markuschr/worklight/README.md

# worklight

Portable 10 W COB LED worklight powered by a 12 V electric drill battery. 

3D printed case, passive cooling, dimmer, low battery warning LED, overdischarge protection. 

This project was done as a part of Principles of repurposing of electronics course at University of Oulu.
