markuschr/worklight/development_notes.md

# LED worklight

Making of a 10 W LED worklight which is connectable to a 12 V Biltema cordless drill battery. Dimmer, low battery LED indicator, and overdischarge protection were implemented.
This project was done as a part of Principles of repurposing of electronics course at University of Oulu.
20211219_162441-COLLAGE

# Parts used

-10 W COB LED (https://www.ebay.de/itm/High-Power-COB-LED-Chip-10W-20W-30W-50W-100W-36V-DC-Fluter-Flutlicht-Leuchte/113407196102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)

-12 V 1.3 Ah cordless drill battery (https://docs.biltema.com/v2/documents/file/fi/f697c127-bde8-4838-9511-e1e3a682050f)

-5A DC-DC Step Down Buck Converter Module with current limiter (https://www.ebay.de/itm/402128636453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)

-old USB car charger

-old computer processor cooling element

-Wemos D1 mini microcontroller (https://www.ebay.de/itm/255283312826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)

-IRLI530NPbF logic level MOSFET (https://www.infineon.com/dgdl/irli530npbf.pdf?fileId=5546d462533600a401535663f87d25bf)

-3mm red LED

-connection board

-on/off switch

-fuse

-10 kohm potentiometer (https://www.spelektroniikka.fi/p11624-monopotentiometri-10-kohm-lineaarinen-metallia-booritettu-akseli-fi.html)

-resistors: 11 kohm, 10 kohm, 3.32 kohm, 100 ohm 

-two Abiko push-on connectors

-wires, screws, glue

# Design procedure

First thing is to attach the LED to the heatsink. Holes can be drilled to the heatsink and then the LED can be secured in place with screws. Some thermal conducting paste can be apllied to the bottom of the LED. Then wires can be soldered to the positive and negative terminals, and connect the wires through multimeter to the buck converter module's output. The buck converter module works as the LED driver. The maximum current and voltage can be selected by rotating the screws in the trimmer potentiometers. The one closer to the output terminals is for the maximum current and the one closer to the input is for the voltage. Before connecting input terminals to 12 V the potentiometers screws should be rotated counter clockwise direction. After connecting the input to 12 V the output should be measured for current and voltage. That way both voltage and current can be set by rotating the potentiometer screws clockwise to max 240 mA and max 12 V.

For making the dimming option the potentiometer that controls the voltage must be removed from the module. By adding a bit of solder to the pins and pulling the potentiometer it comes off pretty easily. Then the trimmer potentiometer can be hot glued to the back of the 10 kohm potentiometer and two wires soldered to the pads on the module, leaving the middle one unconnected. The wires are soldered to the potentiometers along with 11 kohm resistor according to the wiring diagram which can be seen below. After making the connections the trimmer potentiometer screw can still be tuned so that we get the maximum brightness when the bigger potentiometer is rotated to the max.

Next the microcontroller and the regulator for powering it can be added. Any pcb from a car charger that takes 12 V input and outputs 5 V is fine for the regulator. The microcontroller is Wemos D1 mini and one analog input and two digital outputs are used. The analog input is used to measure the voltage of the battery. Analog input takes maximum voltage of 3.3 V so the voltage of 12 V need to be dropped down using two resistors. One digital output is connected to the MOSFET gate pin which controls the LED driver input. The other digital output pin is for the low battery indication LED. 

# Wiring diagram

wiring of the worklight

# Arduino program
The arduino program can be found here: https://github.com/markuschr/worklight/blob/a1ebac3b1dbc1f40e40365d86252e261739fb898/worklight.ino.

The operation is pretty simple: 

First it measures the value from analog input A0 pin and counts an average from last 4 values. 

Then the averaged value is compared to two thresholds, the upper threshold is when the indication LED turns on and the lower threshold is when the pin controlling the MOSFET is put on low which switches off the LED driver input.  Otherwise the the pin controlling the MOSFET is high and the indication LED is low.

When using the cordless drill with the battery the power shuts off when the battery reaches 10.8 V. By using the WiFi connectivity of Wemos D1 mini, the corresponding value for 10.8 V could be measured. The arduino program has lines for connecting to Wifi and writing values to Thingspeak channel. This can be enabled by uncommenting the lines of code and inserting the credentials. The delay must be also increased to 15 seconds because Thingspeak does not accept faster rate for incoming data.

# Case

All the electronics were fitted to 3D printed body and screwed inside to the 3D printed case (roughly 70 mm x 70 mm x 70 mm) and the LED with the cooling element on top of it with a hinge. Connection to the battery was made with push-on Abiko connectors which go through the bottom of the case. Stl files can be found from this repository.

koko design
sisus
holderi
holderi2

# Problems and possible improvements for future revisions
The overdischarge protection does not switch the microcontroller's power off and I did not found a workaround for this. One partial solution could have been to put the microcontroller to deepsleep, but I could not get this to work because when entering deepsleep the pin controlling the MOSFET switch did not stay low and the LED would light up again. Maybe using a different pin would have fixed the problem.

The device could also work as a powerbank when a car charger which has two usb outputs is used. The other one could provide 5 V to the microcontroller and the other port could be inserted to the case for charging a phone or etc.

Remote control of the LED could also be possible to implement with WiFi or even GSM if an old mobile phone is used.
Also a screen could be added to present brightness and batterylevel.
