markuschr/worklight/Body.stl

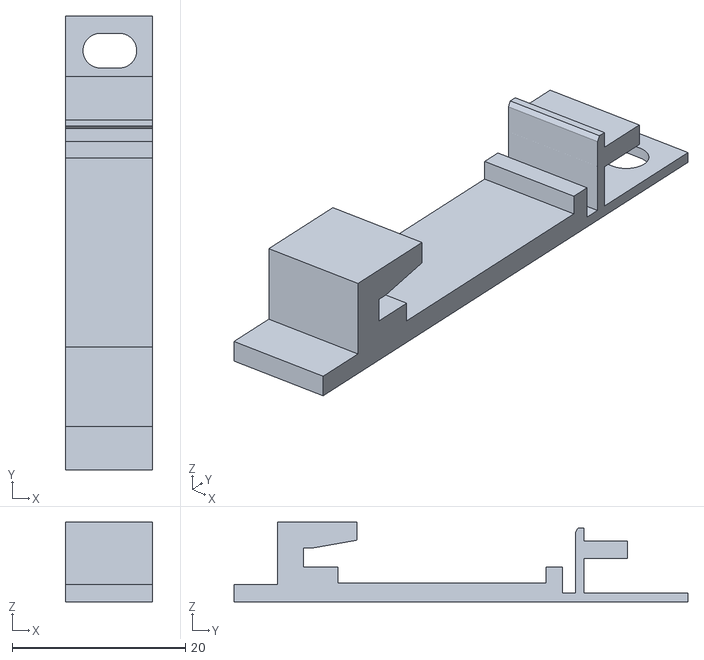
[picture p1: CAD file, 2022-01-10]
Body.stl
10.0 x 52.4 x 9.20
