markuschr/worklight/Body2.stl

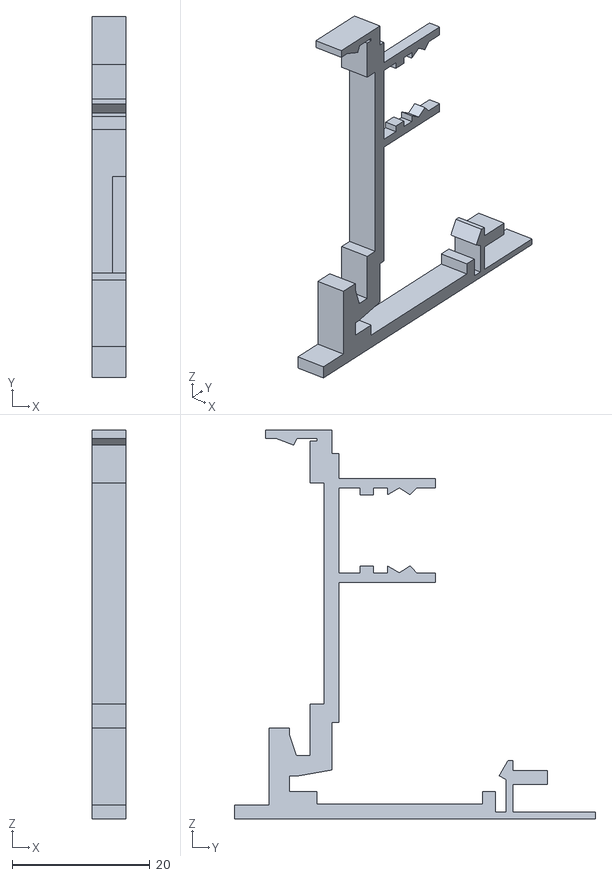
[picture p2: CAD file, 2022-01-10]
Body2.stl
5.00 x 52.4 x 56.4
