markuschr/worklight/case.stl

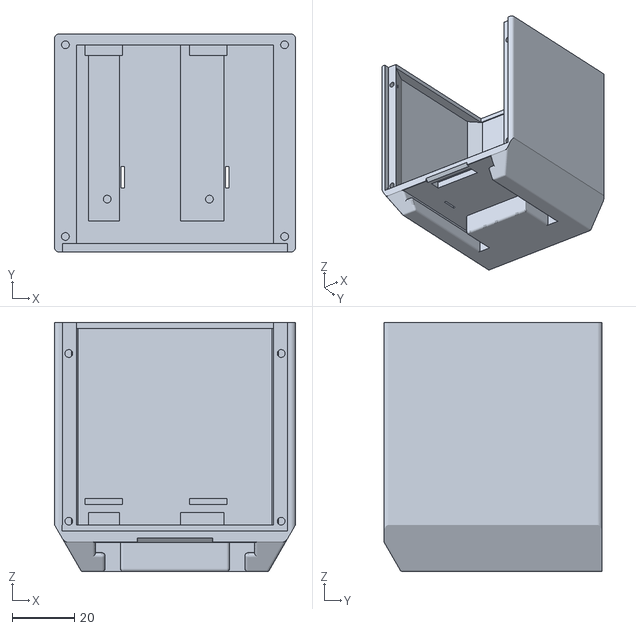
[picture p3: CAD file, 2022-01-10]
case.stl
77.3 x 70.0 x 80.0
