markuschr/worklight/cooling element.stl

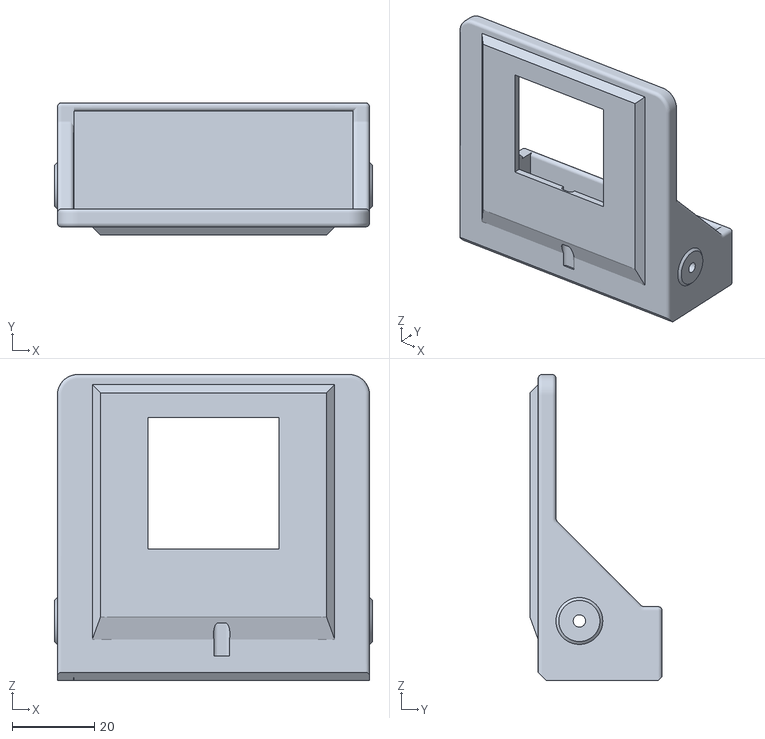
[picture p4: CAD file, 2022-01-10]
cooling element.stl
77.4 x 32.2 x 74.5
