markuschr/worklight/Front.stl

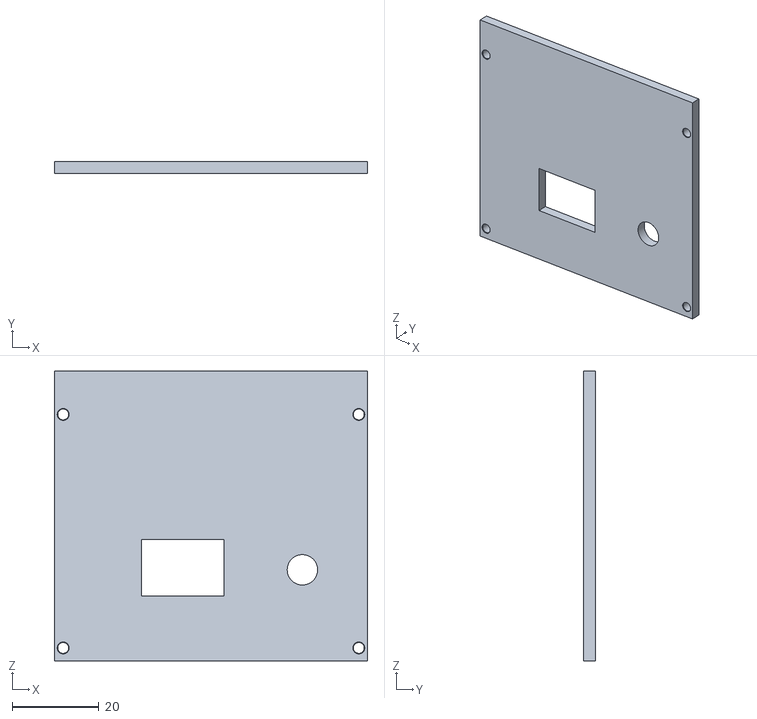
[picture p5: CAD file, 2022-01-10]
Front.stl
72.1 x 2.70 x 66.8
