markuschr/worklight/Top.stl

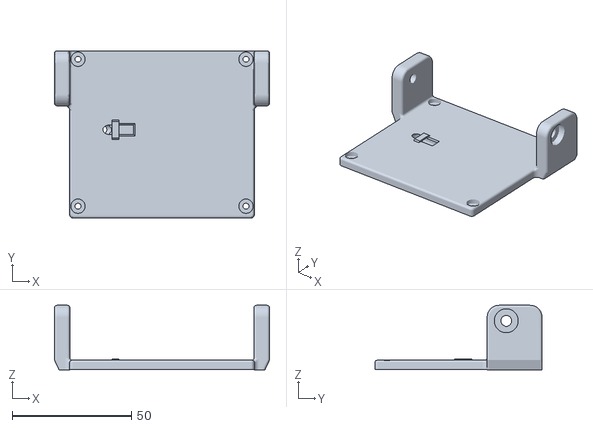
[picture p6: CAD file, 2022-01-10]
Top.stl
90.0 x 70.0 x 27.0
